rheejason/circular-mic-array/hardware/bom/beamformer-bom.tsv

Category | References | Exact qty / PCB | Suggested purchase qty | Item | Manufacturer | Exact MPN | Value / description | Footprint / package | Population | Purchase link | Datasheet | Unit price (USD, at purchase qty) | Line total (USD) | Audit note
IC | U1 | 1 | 2 | Microcontroller | STMicroelectronics | STM32H753ZIT6 | STM32H753, 2 MB Flash, Cortex-M7 | LQFP-144, 20 × 20 mm, 0.5 mm | Populate | https://www.digikey.com/en/products/detail/stmicroelectronics/STM32H753ZIT6/8257856 | https://www.st.com/resource/en/datasheet/stm32h753zi.pdf | 21.25 | 42.50 | Link verified; tray, in stock.
IC | U4 | 1 | 2 | 8-channel PDM-to-I²S/TDM converter | Analog Devices | ADAU7118ACPZRL | 8-channel PDM microphone interface | 16-lead LFCSP, 3 × 3 mm, 0.5 mm pitch, exposed pad | Populate | https://www.digikey.com/en/products/detail/analog-devices-inc/ADAU7118ACPZRL/10249582 | https://www.analog.com/media/en/technical-documentation/data-sheets/ADAU7118.pdf | 8.93 | 17.86 | Link verified. Choose Cut Tape (CT), not Tape & Reel (5000 min).
Sensor | MK1–MK8 | 8 | 12 | Bottom-port PDM MEMS microphone | TDK InvenSense | MMICT5838-00-012 | T5838 digital PDM microphone | Custom 3.5 × 2.65 mm bottom-port LGA | Populate | https://www.digikey.com/en/products/detail/tdk-invensense/MMICT5838-00-012/16903860 | https://invensense.tdk.com/download-pdf/t5838-datasheet/ | 2.03 | 24.34 | Link verified. Only ~100 in stock at DigiKey: order soon. 4 spares (easiest part to damage).
IC | U3 | 1 | 2 | 16-channel I²C LED driver | Texas Instruments | TLC59116FIPWR | 16-channel open-drain PWM LED driver | TSSOP-28, 4.4 × 9.7 mm, 0.65 mm | Populate | https://www.digikey.com/en/products/detail/texas-instruments/TLC59116FIPWR/2353641 | https://www.ti.com/lit/ds/symlink/tlc59116f.pdf | 2.74 | 5.48 | Link verified. F variant: pin 1 NC; no REXT resistor.
IC | U7 | 1 | 3 | 4-bit dual-supply level translator | Texas Instruments | SN74AXC4T774PWR | 1.8 V ↔ 3.3 V logic translation | TSSOP-16, 4.4 × 5 mm, 0.65 mm | Populate | https://www.digikey.com/en/products/detail/texas-instruments/SN74AXC4T774PWR/10715472 | https://www.ti.com/lit/ds/symlink/sn74axc4t774.pdf | 1.31 | 3.93 | Link verified. Channel 4 unused; internal 71 kΩ pull-downs make that OK.
Protection | U2 | 1 | 3 | USB 2.0 ESD protector | STMicroelectronics | USBLC6-2SC6 | Dual-line USB ESD protection | SOT-23-6 | Populate | https://www.digikey.com/en/products/detail/stmicroelectronics/USBLC6-2SC6/1040559 | https://www.st.com/resource/en/datasheet/usblc6-2.pdf | 0.54 | 1.62 | Link verified.
Power | U5 | 1 | 2 | 3.3 V LDO regulator | Microchip Technology | MCP1826S-3302E/DB | Fixed 3.3 V, 1 A | SOT-223-3, tab pin 2 | Populate | https://www.digikey.com/en/products/detail/microchip-technology/MCP1826S-3302E-DB/1635997 | https://ww1.microchip.com/downloads/aemDocuments/documents/OTH/ProductDocuments/DataSheets/22057B.pdf | 0.91 | 1.82 | Link verified. 4 thermal vias in tab pad.
Power | U6 | 1 | 3 | 1.8 V LDO regulator | Texas Instruments | TLV75518PDBVR | Fixed 1.8 V, 500 mA | SOT-23-5 (DBV) | Populate | https://www.digikey.com/en/products/detail/texas-instruments/TLV75518PDBVR/9685549 | https://www.ti.com/lit/ds/symlink/tlv755p.pdf | 0.42 | 1.26 | Link verified. EN tied to 3.3 V.
Connector | J2 | 1 | 2 | Vertical USB-C USB 2.0 receptacle | GCT | USB4145-03-0170-C | 16-contact USB-C, 1.70 mm shell stakes | USB4145 vertical SMT + 4 THT shell stakes | Populate | https://www.digikey.com/en/products/detail/gct/USB4145-03-0170-C/16649098 | https://gct.co/download?name=USB4145.pdf&type=PDFDrawing | 1.05 | 2.10 | Link verified. Footprint matches GCT recommended layout (0170 = 1.7 mm stakes for 1.6 mm board).
Connector | J1 | 1 | 2 | 1 × 5 SWD header | Würth Elektronik | 61300511121 | 2.54 mm vertical male header | Through-hole 1 × 5, 2.54 mm | Populate | https://www.digikey.com/en/products/detail/w%C3%BCrth-elektronik/61300511121/4846831 | https://www.we-online.com/components/products/datasheet/61300511121.pdf | 0.25 | 0.50 | Link verified. Pins: 3V3 ref, GND, SWDIO, SWCLK, NRST.
Connector | J3 | 1 | 2 | 1 × 6 debug header | Würth Elektronik | 61300611121 | 2.54 mm vertical male header | Through-hole 1 × 6, 2.54 mm | Populate or DNP | https://www.digikey.com/en/products/detail/w%C3%BCrth-elektronik/61300611121/4846833 | https://www.we-online.com/components/products/datasheet/61300611121.pdf | 0.33 | 0.66 | Link verified. GND, FS, BCLK, SDATA (1.8 V), RX, TX.
Clock | Y1 | 1 | 3 | 16 MHz HSE crystal | ECS Inc. | ECS-160-8-30Q-VY-TR | 16 MHz, 8 pF load, ±30 ppm, 50 Ω ESR | ECX-53Q, 5.0 × 3.2 mm, 2-pad | Populate | https://www.digikey.com/en/products/detail/ecs-inc/ECS-160-8-30Q-VY-TR/10239156 | https://ecsxtal.com/store/pdf/ECX-53Q.pdf | 0.83 | 2.49 | Link verified. Land pattern matches ECS recommendation.
LED | D1–D16 | 16 | 20 | Right-angle blue LED | Kingbright | AA4040QBS/G | Blue side-emitting indicator LED | Custom AA4040QBS/G, 1.7 × 4.0 mm pads | Populate | https://www.digikey.com/en/products/detail/kingbright/AA4040QBS-G/15907336 | https://www.kingbrightusa.com/images/catalog/SPEC/AA4040QBS-G.pdf | 0.77 | 15.44 | Link verified. Pad 1 cathode; pad 2 anode.
Resistor | R1–R16 | 16 | 25 | LED current-limiting resistor | YAGEO | RC0805FR-07220RL | 220 Ω, 1%, 0805 | R_0805_2012Metric | Populate | https://www.digikey.com/en/products/detail/yageo/RC0805FR-07220RL/727741 | https://www.yageo.com/upload/media/product/productsearch/datasheet/rchip/PYu-RC_Group_51_RoHS_L_12.pdf | 0.026 | 0.64 | Link verified. ≈ 8.6 mA per LED.
Resistor | R1–R16 (alternate) | 0 | 25 | Brighter LED resistor option | YAGEO | RC0805FR-07100RL | 100 Ω, 1%, 0805 | R_0805_2012Metric | Optional | https://www.digikey.com/en/products/detail/yageo/RC0805FR-07100RL/727543 | https://www.yageo.com/upload/media/product/productsearch/datasheet/rchip/PYu-RC_Group_51_RoHS_L_12.pdf | 0.026 | 0.64 | NEW. ≈ 17 mA per LED if 220 Ω looks dim behind the diffuser; don't run all 16 at full PWM on USB power.
Resistor | R17, R20 | 2 | 10 | I²C pull-up resistor | YAGEO | RC0805FR-074K7L | 4.7 kΩ, 1%, 0805 | R_0805_2012Metric | Populate | https://www.digikey.com/en/products/detail/yageo/RC0805FR-074K7L/727929 | https://www.yageo.com/upload/media/product/productsearch/datasheet/rchip/PYu-RC_Group_51_RoHS_L_12.pdf | 0.034 | 0.34 | Link verified. SCL and SDA pull-ups to 3.3 V.
Resistor | R18, R23 | 2 | 10 | Logic pull resistor | YAGEO | RC0805FR-0710KL | 10 kΩ, 1%, 0805 | R_0805_2012Metric | Populate | https://www.digikey.com/en/products/detail/yageo/RC0805FR-0710KL/727535 | https://www.yageo.com/upload/media/product/productsearch/datasheet/rchip/PYu-RC_Group_51_RoHS_L_12.pdf | 0.034 | 0.34 | Link verified. TLC reset pull-up and MCU BOOT0 pull-down.
Resistor | R21, R22 | 2 | 10 | USB-C CC pull-down resistor | YAGEO | RC0805FR-075K1L | 5.1 kΩ, 1%, 0805 | R_0805_2012Metric | Populate | https://www.digikey.com/en/products/detail/yageo/RC0805FR-075K1L/730935 | https://www.yageo.com/upload/media/product/productsearch/datasheet/rchip/PYu-RC_Group_51_RoHS_L_12.pdf | 0.034 | 0.34 | Link verified. One independent Rd from each CC pin to GND.
Capacitor | C1, C2, C8–C19, C24–C35, C37, C39 | 28 | 50 | General decoupling capacitor | Samsung Electro-Mechanics | CL21B104KBCNNNC | 0.1 µF, 50 V, X7R, 0805 | C_0805_2012Metric | Populate | https://www.digikey.com/en/products/detail/samsung-electro-mechanics/CL21B104KBCNNNC/3886661 | https://product.samsungsem.com/mlcc/CL21B104KBCNNNC.do | 0.031 | 1.54 | Link verified. Count verified against schematic and PCB.
Capacitor | C4–C7, C36, C38 | 6 | 10 | Supply decoupling capacitor | Murata Electronics | GRM21BR71A105KA01L | 1 µF, 10 V, X7R, 0805 | C_0805_2012Metric | Populate | https://www.digikey.com/en/products/detail/murata-electronics/GRM21BR71A105KA01L/586695 | https://www.murata.com/en-us/products/productdetail?partno=GRM21BR71A105KA01%23 | 0.106 | 1.06 | Link verified. Regulator, VDDA and USB supply decoupling.
Capacitor | C22, C23 | 2 | 10 | STM32 VCAP capacitor | Murata Electronics | GRM21BR71A225KA01L | 2.2 µF, 10 V, X7R, 0805 | C_0805_2012Metric | Populate | https://www.digikey.com/en/products/detail/murata-electronics/GRM21BR71A225KA01L/446245 | https://www.murata.com/en-us/products/productdetail?partno=GRM21BR71A225KA01%23 | 0.099 | 0.99 | Link verified. One capacitor at each VCAP pin.
Capacitor | C20, C21 | 2 | 10 | Crystal load capacitor | KEMET | C0805C100J5GACTU | 10 pF, 50 V, C0G/NP0, 0805 | C_0805_2012Metric | Populate | https://www.digikey.com/en/products/detail/kemet/C0805C100J5GACTU/411107 | https://content.kemet.com/datasheets/KEM_C1002_C0G_SMD.pdf | 0.076 | 0.76 | Link verified.
Capacitor | C3, C40 | 2 | 10 | Bulk/decoupling capacitor | TDK | C2012X7R1A475K085AC | 4.7 µF, 10 V, X7R, 0805 | C_0805_2012Metric | Populate | https://www.digikey.com/en/products/detail/tdk/C2012X7R1A475K085AC/3951763 | https://product.tdk.com/en/search/capacitor/ceramic/mlcc/info?part_no=C2012X7R1A475K085AC | 0.168 | 1.68 | LINK FIXED: old link (…/3956380) opened a 0.47 µF 100 V 1206 part. C3 is USB VBUS bulk; C40 is MCU bulk.
Cable | (off-board) | 1 | 1 | USB-C extension, right-angle male to panel-mount female | Generic (usb-fever UF006480-SS) | UF006480-SS | USB 3.1 / USB-C, 0.3 m, data + charging, panel screws 17 mm apart | — | Buy | https://www.usbfever.com/superp-short-panel-mount-usb-c-female-to-usb-male-jumper-extender-cable | — | 7.99 | 7.99 | Select the "Right-Angled" option. 30 cm: coil it in the base.
TOTAL (parts, before shipping/tax; PCB + stencil quoted separately at JLC) |  |  |  |  |  |  |  |  |  |  |  |  | 136.32 | DigiKey cut-tape prices checked 2026-10-25.
