rheejason/circular-mic-array/hardware/kicad/beamformer/3dmodels/AA4040.STEP

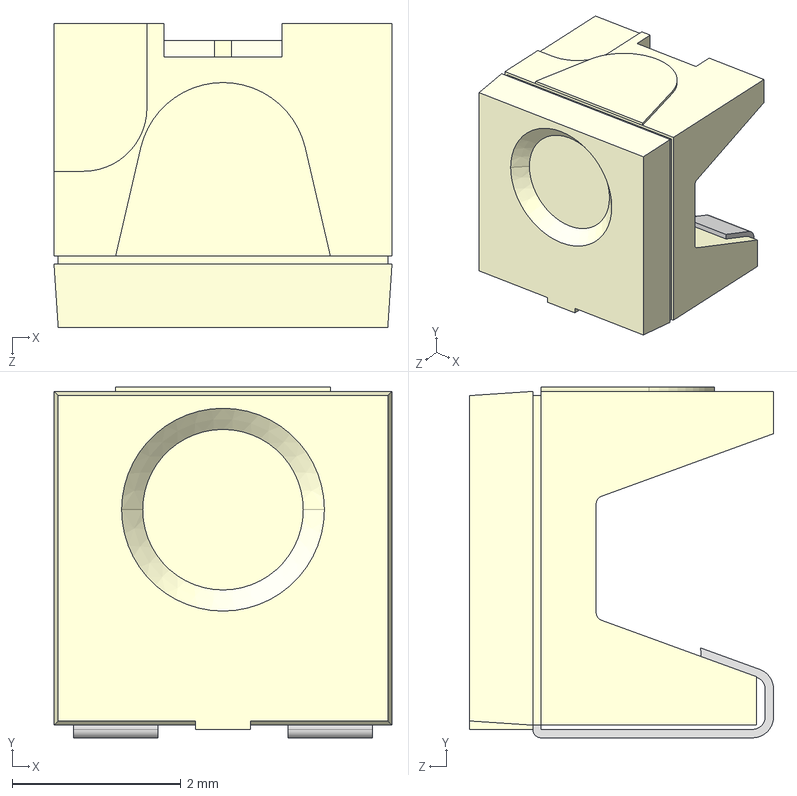
[picture p1: CAD file, 2026-10-24]
hardware/kicad/beamformer/3dmodels/AA4040.STEP
4.00 x 4.15 x 3.60 mm
