rheejason/circular-mic-array/hardware/kicad/beamformer/beamformer.kicad_pcb

## KiCad design hardware/kicad/beamformer/beamformer.kicad_pcb (2026-11-03)

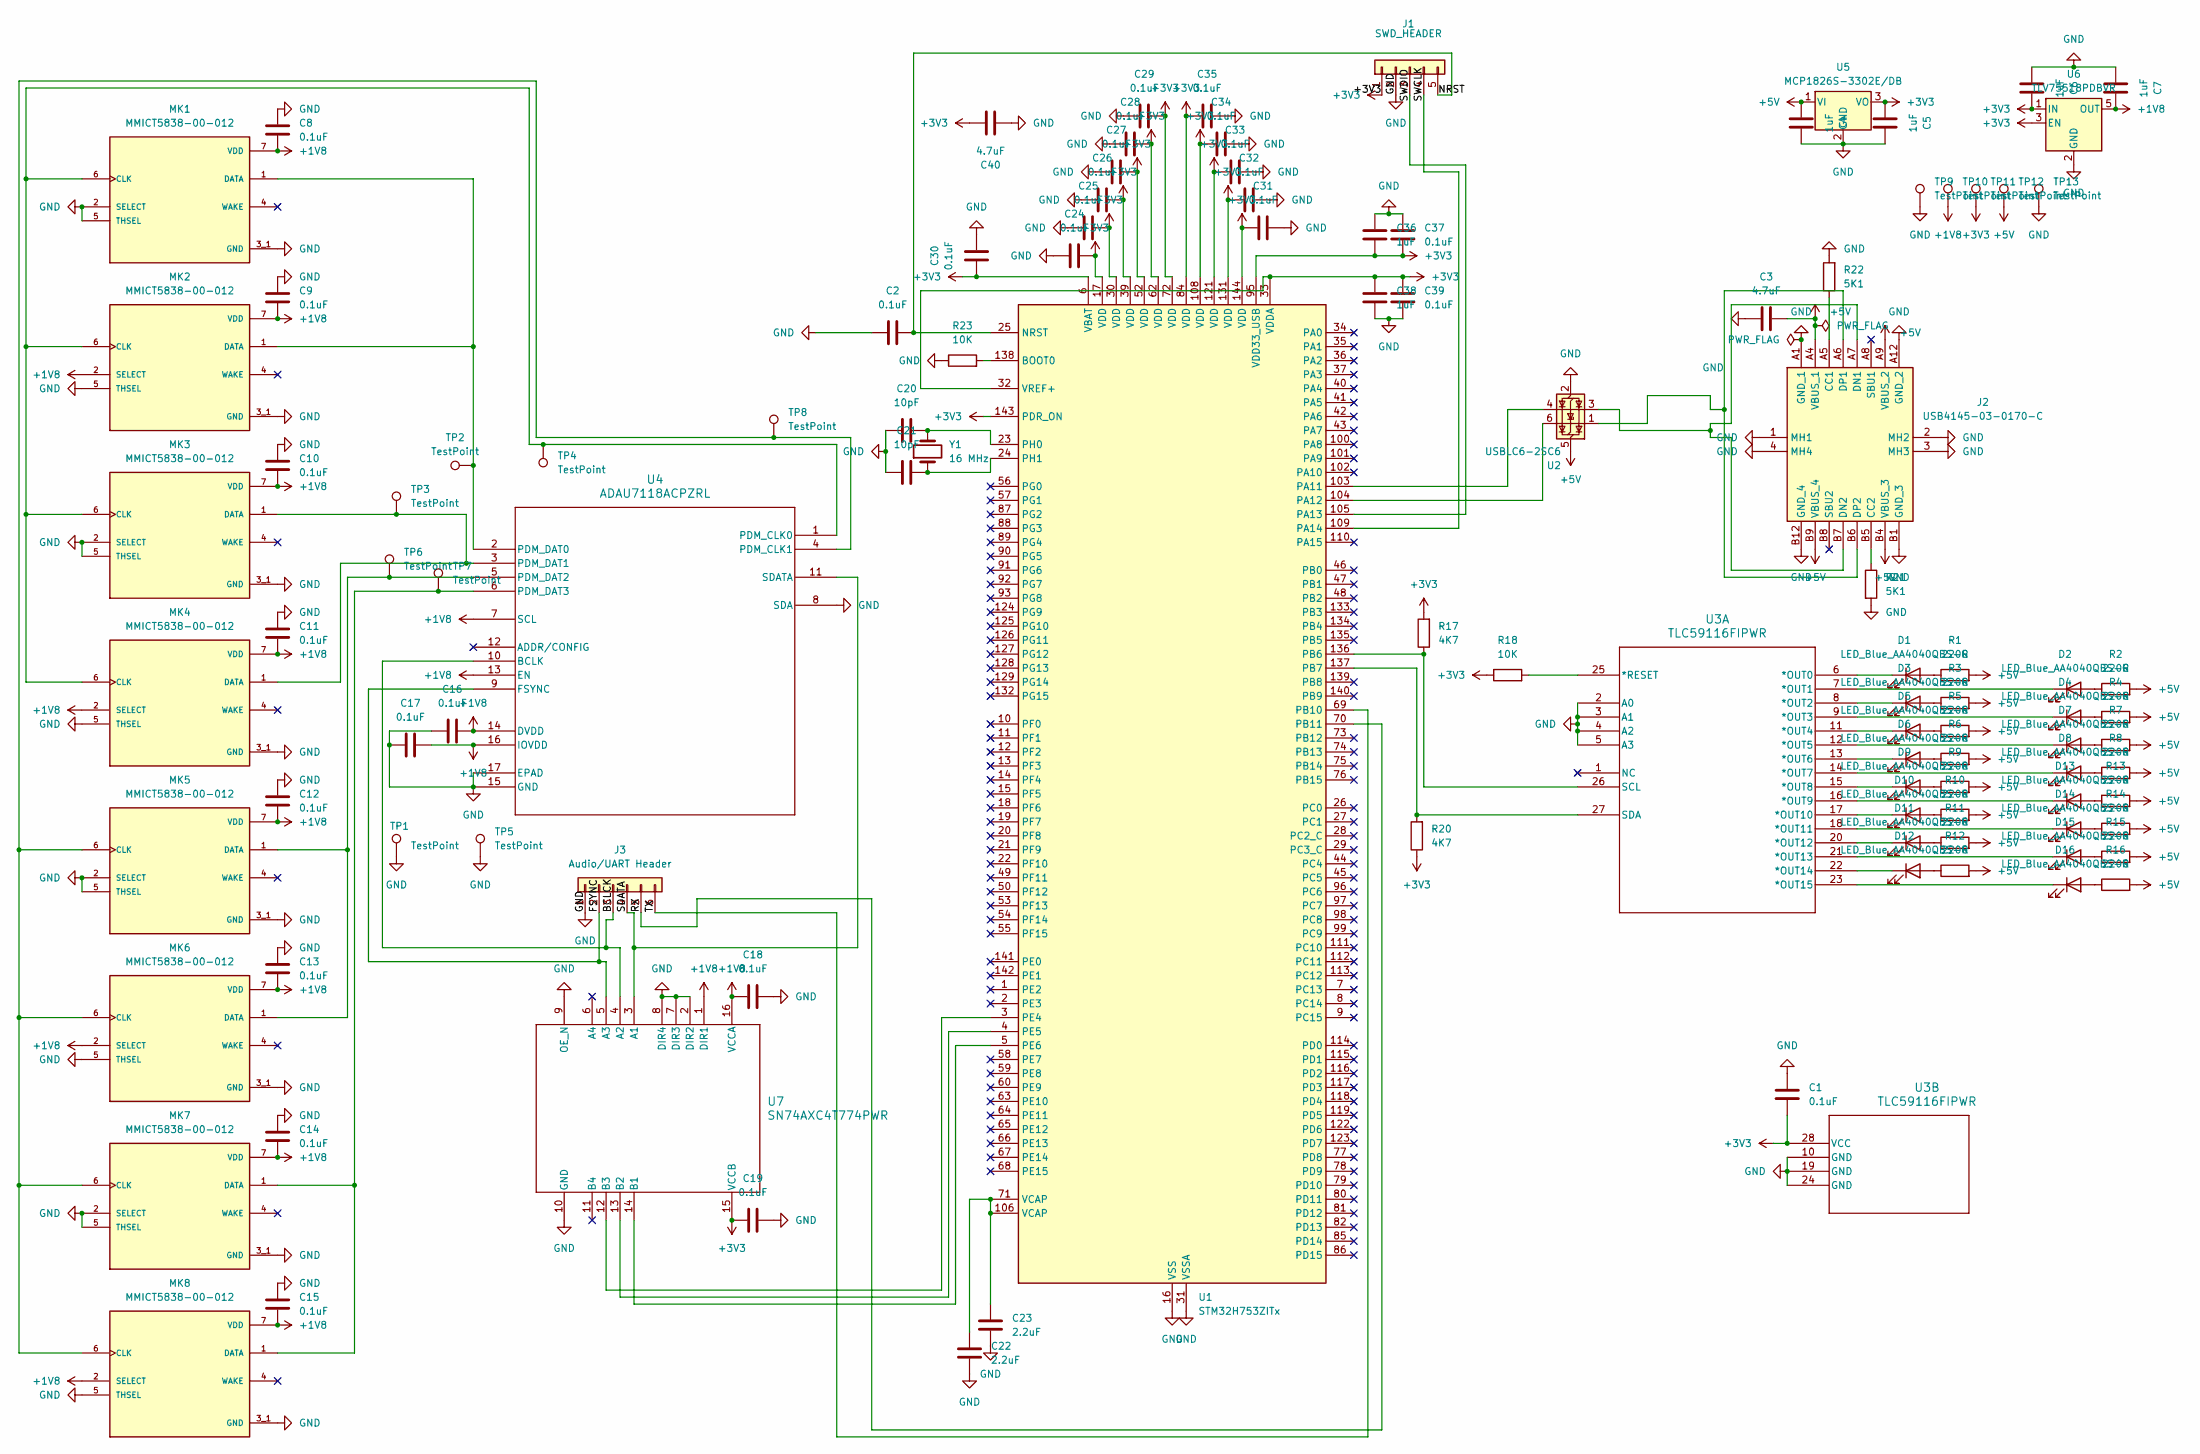
[picture p2: schematic beamformer.kicad_sch]

Parts:
C1, C2, C8, C9, C10, C11, C12, C13, C14, C15, C16, C17, C18, C19, C24, C25, C26, C27, C28, C29, C30, C31, C32, C33, C34, C35, C37, C39: 0.1uF; C_0805_2012Metric
C3, C40: 4.7uF; C_0805_2012Metric
C4, C5, C6, C7, C36, C38: 1uF; C_0805_2012Metric
C20, C21: 10pF; C_0805_2012Metric
C22, C23: 2.2uF; C_0805_2012Metric
D1, D2, D3, D4, D5, D6, D7, D8, D9, D10, D11, D12, D13, D14, D15, D16: LED_Blue_AA4040QBS-G; LED_Kingbright_AA4040QBS-G
J1: SWD_HEADER; PinHeader_1x05_P2.54mm_Vertical
J2: USB4145-03-0170-C; CONN_USB4145-03-0230-C_GCT; Manufacturer_Part_Number USB4145-03-0170-C; Mouser Part Number 640-USB4145-3-0170-C
J3: Audio/UART Header; PinHeader_1x06_P2.54mm_Vertical
MK1, MK2, MK3, MK4, MK5, MK6, MK7, MK8: MMICT5838-00-012; MIC_MMICT5838-00-012; PARTREV 1.1
R1, R2, R3, R4, R5, R6, R7, R8, R9, R10, R11, R12, R13, R14, R15, R16: 220R; R_0805_2012Metric
R17, R20: 4K7; R_0805_2012Metric
R18, R23: 10K; R_0805_2012Metric
R21, R22: 5K1; R_0805_2012Metric
TP1, TP2, TP3, TP4, TP5, TP6, TP7, TP8, TP9, TP10, TP11, TP12, TP13: TestPoint; TestPoint_Pad_D1.5mm
U1: STM32H753ZITx; LQFP-144_20x20mm_P0.5mm
U2: USBLC6-2SC6; SOT-23-6
U3: TLC59116FIPWR; TSSOP-28_4.4x9.7mm_P0.65mm
U4: ADAU7118ACPZRL; CP-16-22_ADI
U5: MCP1826S-3302E/DB; SOT-223-3_TabPin2
U6: TLV75518PDBVR; SOT-23-5
U7: SN74AXC4T774PWR; TSSOP-16_4.4x5mm_P0.65mm
Y1: 16 MHz; ECS-160-8-30Q-VY-TR

Connections:
+1V8: C7.2, C8.1, C9.1, C10.1, C11.1, C12.1, C13.1, C14.1, C15.1, C16.1, C17.1, C18.2, MK1.7 (VDD), MK2.2 (SELECT), MK2.7 (VDD), MK3.7 (VDD), MK4.2 (SELECT), MK4.7 (VDD), MK5.7 (VDD), MK6.2 (SELECT), MK6.7 (VDD), MK7.7 (VDD), MK8.2 (SELECT), MK8.7 (VDD), TP10.1 (1_1), U4.7 (SCL), U4.13 (EN), U4.14 (DVDD), U4.16 (IOVDD), U6.5 (OUT), U7.1 (DIR1), U7.16 (VCCA)
+3V3: C1.2, C5.1, C6.2, C19.2, C24.2, C25.2, C26.2, C27.2, C28.2, C29.2, C30.1, C31.2, C32.2, C33.2, C34.2, C35.2, C36.2, C37.2, C38.1, C39.1, C40.2, J1.1, R17.2, R18.1, R20.1, TP11.1 (1_1), U1.6 (VBAT), U1.17 (VDD), U1.30 (VDD), U1.32 (VREF+), U1.33 (VDDA), U1.39 (VDD), U1.52 (VDD), U1.62 (VDD), U1.72 (VDD), U1.84 (VDD), U1.95 (VDD33_USB), U1.108 (VDD), U1.121 (VDD), U1.131 (VDD), U1.143 (PDR_ON), U1.144 (VDD), U3.28 (VCC), U5.3 (VO), U6.1 (IN), U6.3 (EN), U7.15 (VCCB)
+5V: C3.2, C4.1, J2.A4 (VBUS_1), J2.A9 (VBUS_2), J2.B4 (VBUS_3), J2.B9 (VBUS_4), R1.2, R2.2, R3.2, R4.2, R5.2, R6.2, R7.2, R8.2, R9.2, R10.2, R11.2, R12.2, R13.2, R14.2, R15.2, R16.2, TP12.1 (1_1), U2.5 (VBUS), U5.1 (VI)
/BCLCK: J3.3, U4.10 (BCLK), U7.4 (A2)
/FSYNC: J3.2, U4.9 (FSYNC), U7.5 (A3)
/NRST: C2.2, J1.5, U1.25 (NRST)
/RX: J3.5, U1.70 (PB11)
/SDATA: J3.4, U4.11 (SDATA), U7.3 (A1)
/SWCLK: J1.4, U1.109 (PA14)
/SWDIO: J1.3, U1.105 (PA13)
/TX: J3.6, U1.69 (PB10)
GND: C1.1, C2.1, C3.1, C4.2, C5.2, C6.1, C7.1, C8.2, C9.2, C10.2, C11.2, C12.2, C13.2, C14.2, C15.2, C16.2, C17.2, C18.1, C19.1, C20.1, C21.1, C22.2, C23.2, C24.1, C25.1, C26.1, C27.1, C28.1, C29.1, C30.2, C31.1, C32.1, C33.1, C34.1, C35.1, C36.1, C37.1, C38.2, C39.2, C40.1, J1.2, J2.1 (MH1), J2.2 (MH2), J2.3 (MH3), J2.4 (MH4), J2.A1 (GND_1), J2.A12 (GND_2), J2.B1 (GND_3), J2.B12 (GND_4), J3.1, MK1.2 (SELECT), MK1.3_1 (GND), MK1.3_2 (GND), MK1.5 (THSEL), MK2.3_1 (GND), MK2.3_2 (GND), MK2.5 (THSEL), MK3.2 (SELECT), MK3.3_1 (GND), MK3.3_2 (GND), MK3.5 (THSEL), MK4.3_1 (GND), MK4.3_2 (GND), MK4.5 (THSEL), MK5.2 (SELECT), MK5.3_1 (GND), MK5.3_2 (GND), MK5.5 (THSEL), MK6.3_1 (GND), MK6.3_2 (GND), MK6.5 (THSEL), MK7.2 (SELECT), MK7.3_1 (GND), MK7.3_2 (GND), MK7.5 (THSEL), MK8.3_1 (GND), MK8.3_2 (GND), MK8.5 (THSEL), R21.2, R22.2, R23.1, TP1.1 (1_1), TP5.1 (1_1), TP9.1 (1_1), TP13.1 (1_1), U1.16 (VSS), U1.31 (VSSA), U1.38 (VSS), U1.51 (VSS), U1.61 (VSS), U1.83 (VSS), U1.94 (VSS), U1.107 (VSS), U1.120 (VSS), U1.130 (VSS), U2.2 (GND), U3.2 (A0), U3.3 (A1), U3.4 (A2), U3.5 (A3), U3.10 (GND), U3.19 (GND), U3.24 (GND), U4.8 (SDA), U4.15 (GND), U4.17 (EPAD), U5.2 (GND), U6.2 (GND), U7.2 (DIR2), U7.7 (DIR3), U7.8 (DIR4), U7.9 (OE_N), U7.10 (GND)
unnamed: C22.1, C23.1, U1.71 (VCAP), U1.106 (VCAP)
unnamed: D1.2 (A), R1.1
unnamed: D1.1 (K), U3.6 (*OUT0)
unnamed: D2.2 (A), R2.1
unnamed: D2.1 (K), U3.7 (*OUT1)
unnamed: D3.2 (A), R3.1
unnamed: D3.1 (K), U3.8 (*OUT2)
unnamed: D4.2 (A), R4.1
unnamed: D4.1 (K), U3.9 (*OUT3)
unnamed: D5.2 (A), R5.1
unnamed: D5.1 (K), U3.11 (*OUT4)
unnamed: D6.2 (A), R6.1
unnamed: D6.1 (K), U3.13 (*OUT6)
unnamed: D7.2 (A), R7.1
unnamed: D7.1 (K), U3.12 (*OUT5)
unnamed: D8.2 (A), R8.1
unnamed: D8.1 (K), U3.14 (*OUT7)
unnamed: D9.2 (A), R9.1
unnamed: D9.1 (K), U3.15 (*OUT8)
unnamed: D10.2 (A), R10.1
unnamed: D10.1 (K), U3.17 (*OUT10)
unnamed: D11.2 (A), R11.1
unnamed: D11.1 (K), U3.20 (*OUT12)
unnamed: D12.2 (A), R12.1
unnamed: D12.1 (K), U3.22 (*OUT14)
unnamed: D13.2 (A), R13.1
unnamed: D13.1 (K), U3.16 (*OUT9)
unnamed: D14.2 (A), R14.1
unnamed: D14.1 (K), U3.18 (*OUT11)
unnamed: D15.2 (A), R15.1
unnamed: D15.1 (K), U3.21 (*OUT13)
unnamed: D16.2 (A), R16.1
unnamed: D16.1 (K), U3.23 (*OUT15)
unnamed: J2.A5 (CC1), R22.1
unnamed: J2.B5 (CC2), R21.1
unnamed: J2.A7 (DN1), J2.B7 (DN2), U2.3 (I/O2)
unnamed: J2.A6 (DP1), J2.B6 (DP2), U2.1 (I/O1)
unnamed: MK1.6 (CLK), MK2.6 (CLK), MK3.6 (CLK), MK4.6 (CLK), TP4.1 (1_1), U4.1 (PDM_CLK0)
unnamed: MK1.1 (DATA), MK2.1 (DATA), TP2.1 (1_1), U4.2 (PDM_DAT0)
unnamed: MK3.1 (DATA), MK4.1 (DATA), TP3.1 (1_1), U4.3 (PDM_DAT1)
unnamed: MK5.6 (CLK), MK6.6 (CLK), MK7.6 (CLK), MK8.6 (CLK), TP8.1 (1_1), U4.4 (PDM_CLK1)
unnamed: MK5.1 (DATA), MK6.1 (DATA), TP6.1 (1_1), U4.5 (PDM_DAT2)
unnamed: MK7.1 (DATA), MK8.1 (DATA), TP7.1 (1_1), U4.6 (PDM_DAT3)
unnamed: R23.2, U1.138 (BOOT0)
unnamed: U1.103 (PA11), U2.4 (I/O2)
unnamed: U1.104 (PA12), U2.6 (I/O1)
unnamed: R17.1, U1.136 (PB6), U3.26 (SCL)
unnamed: R20.2, U1.137 (PB7), U3.27 (SDA)
unnamed: U1.3 (PE4), U7.12 (B3)
unnamed: U1.4 (PE5), U7.13 (B2)
unnamed: U1.5 (PE6), U7.14 (B1)
unnamed: C20.2, U1.23 (PH0), Y1.2
unnamed: C21.2, U1.24 (PH1), Y1.1
unnamed: R18.2, U3.25 (*RESET)

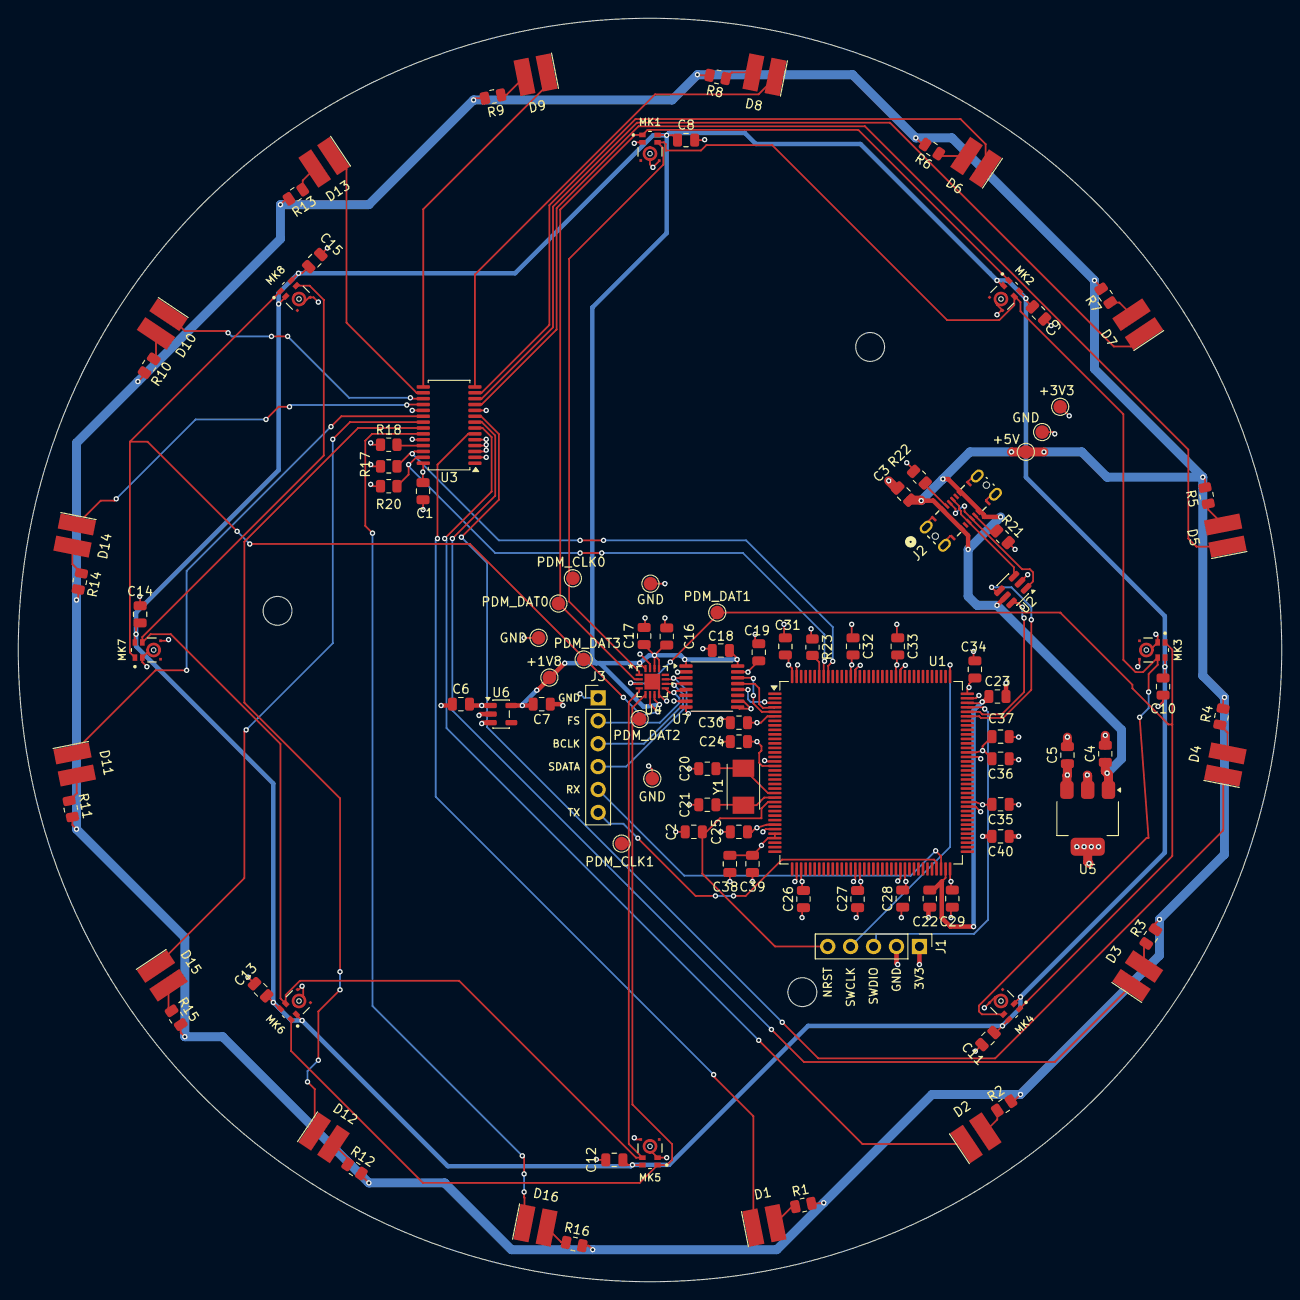
[picture p3: board beamformer.kicad_pcb from above]

Board: 4 copper layers, 140.0 x 140.0 mm, 113 parts (0 on the bottom side), 66 nets.

Other parts of the board:
H1, H2, H3: MountingHole_3.2mm_M3
