rheejason/circular-mic-array/firmware/circular-mic-pcb/circular-mic-pcb.ioc

Mcu.UserName=STM32H753ZITx
PA11.Signal=USB_OTG_FS_DM
PA12.Signal=USB_OTG_FS_DP
PB10.Signal=USART3_TX
PB11.Signal=USART3_RX
PB6.Signal=I2C1_SCL
PB7.Signal=I2C1_SDA
PE4.Signal=SAI1_FS_A
PE5.Signal=SAI1_SCK_A
PE6.Signal=SAI1_SD_A
