rheejason/circular-mic-array/(commit log)

2026-10-13 beamformer schematic progress
2026-10-13 schematic progress
2026-10-19 Updated drivers and paths for CMSIS/DSP for DOA
2026-10-20 final schematic version and pcb update
2026-10-22 pcb wiring started
2026-10-24 PCB complete
2026-10-25 Added mounting holes tp pcb
2026-11-11 Added final pcb project
2026-11-11 Added LED test
